ClemensGruber/deggl-mandl/deggl-mandl.h

// ** Definition der pins
// ----------------------

#define startSwitch 6  // Microswitch am Hebelarm
#define pwmEngine 10  
#define ONE_WIRE_BUS 5  // Temperatur-Sensoren = 8;

// Rotary Encoder
#define outputA  3 // CLK
#define outputB  2 // DT
#define outputSW 4 // Switch

int buttonState = HIGH;

// Allgemeine Variablen

int current = 0;
int currentAfterburner = 0;
int torqCurrent = 1800;     // max. Strom in mA
int afterburner = 80;       // Nachlauf in ms. Definiert das Drehmoment ! 
int rpmPWM = 255;           // PWM für Motordrehzahl
unsigned long timeStamp;
unsigned long lastDebounceTime;
int debounceDelay = 5;
