ClemensGruber/deggl-mandl/(commit log)

2021-02-04 added pictures PCB
2021-02-04 added PCB pictures
2021-02-05 typo Dateinamen fixed und neue Platinenansicht
2021-02-05 kleinere Umformatierungen und Kommentare
2021-02-06 ver 0.1b
    unbounced StartSwitch
    Temperatursemsoren
2021-02-06 ver 0.1b
    minor fixes
    [deggl-mandl.ino]
2021-02-17 test ver
    splitting ArduinoIDE / platformIO
2021-02-17 ver 0.1pio3
    platformIO & ArduinoIDE Support
2021-02-20 ver 0.1pio4
    RotarySwitch toggles between current and afterburner
2021-02-22 ver0.1pio4
    Rotary-Switch: Ready -> config current -> config afterburner -> Ready
2021-02-23 ver0.1pio4 bugfix
    minor bugfixes
    [deggl-mandl.ino, tools.h]
2021-02-27 ver 0.2b
    Motor PWM Pin von D6 auf D11 umgelegt, StartSwitch auf D10 umgelegt, PWM Frequenz über Register TCCR2B zwischen 30Hz und 31KHz einstellbar
2021-02-27 ver 0.2c
    Anzahl und Reihenfolge der Temperatursensoren konfigurierbar
2021-02-28 ver 0.2d
    Minor bugfixes
    [deggl-mandl.ino, vars.h]
2023-11-25 Buzzer added
    Passiven Buzzer auf Pin 9 hinzugefügt. Kann im Menü konfiguriert werden.
    [deggl-mandl.ino, tools.h, vars.h]
